maultxyz/mault/(list of files, cad)

Other CAD files:
3d model/Card Sorter.step
3d model/Card Sorter.f3d
3d model/card_sorter.3mf
