maultxyz/mault/packages/server/tests/fixtures/scan-control/invalid.png

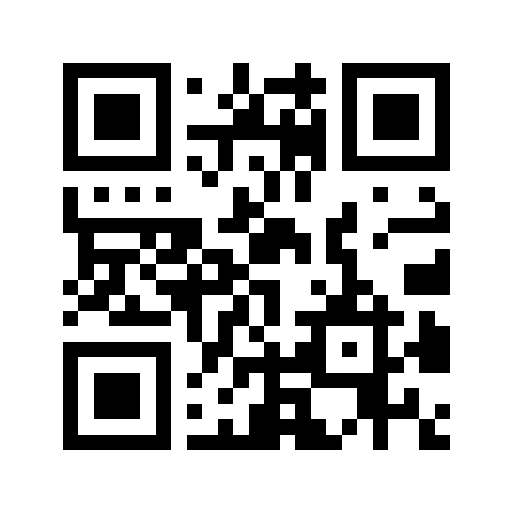
packages/server/tests/fixtures/scan-control/invalid.png
