maultxyz/mault/firmware/main/ble_esp32.ino

// BLE backend for ESP32-S3, using the Bluedroid stack bundled with the
// esp32:esp32 Arduino core (BLEDevice/BLEServer/BLECharacteristic - already
// installed by firmware-release.yml/firmware-pr-check.yml's `arduino-cli
// core install esp32:esp32`, no extra library needed). Implements the same
// bleInit()/blePoll()/bleIsConnected()/bleSendLine() contract as
// ble_arduinoble.ino so main.ino never branches on which backend is active -
// see main.ino's BLE_SUPPORTED/BLE_BACKEND_* macros for the board gating.
#if BLE_BACKEND_ESP32
#include <BLE2902.h>
#include <BLEDevice.h>
#include <BLEServer.h>
#include <BLEUtils.h>

// Nordic UART Service (NUS) - a widely-recognized BLE "serial" convention,
// reused here (rather than inventing our own UUIDs) so generic BLE terminal
// apps (nRF Connect etc.) can talk to this device for debugging without any
// app-specific tooling. RX = commands in (write), TX = responses/unsolicited
// messages out (notify) - see PROTOCOL.md's BLE Transport section. Must
// match ble_arduinoble.ino's UUIDs exactly, since the web client looks for
// one fixed service regardless of which board it's talking to.
#define BLE_SERVICE_UUID "6E400001-B5A3-F393-E0A9-E50E24DCCA9E"
#define BLE_RX_UUID "6E400002-B5A3-F393-E0A9-E50E24DCCA9E"
#define BLE_TX_UUID "6E400003-B5A3-F393-E0A9-E50E24DCCA9E"

#define BLE_PREFERRED_MTU 517
#define BLE_DEFAULT_MTU 23
#define BLE_ATT_HEADER_SIZE 3
#define BLE_CHUNK_GAP_MS 5
#define BLE_CONN_INTERVAL_MIN 6
#define BLE_CONN_INTERVAL_MAX 24
#define BLE_CONN_SUPERVISION_TIMEOUT 400
#define BLE_RX_RING_SIZE 512

char bleRxRing[BLE_RX_RING_SIZE];
volatile size_t bleRxHead = 0;
volatile size_t bleRxTail = 0;
portMUX_TYPE bleRxMux = portMUX_INITIALIZER_UNLOCKED;

bool bleRxPop(char& c) {
  bool available = false;
  portENTER_CRITICAL(&bleRxMux);
  if (bleRxTail != bleRxHead) {
    c = bleRxRing[bleRxTail];
    bleRxTail = (bleRxTail + 1) % BLE_RX_RING_SIZE;
    available = true;
  }
  portEXIT_CRITICAL(&bleRxMux);
  return available;
}

BLEServer* bleServer = nullptr;
BLECharacteristic* bleTxChar = nullptr;
volatile bool bleConnected = false;

class SorterServerCallbacks : public BLEServerCallbacks {
  void onConnect(BLEServer* server) override { bleConnected = true; }
#if defined(CONFIG_NIMBLE_ENABLED)
  void onConnect(BLEServer* server, ble_gap_conn_desc* desc) override {
    server->requestConnParams(desc->conn_handle, BLE_CONN_INTERVAL_MIN, BLE_CONN_INTERVAL_MAX, 0,
                              BLE_CONN_SUPERVISION_TIMEOUT);
  }
#elif defined(CONFIG_BLUEDROID_ENABLED)
  void onConnect(BLEServer* server, esp_ble_gatts_cb_param_t* param) override {
    server->requestConnParams(param->connect.remote_bda, BLE_CONN_INTERVAL_MIN,
                              BLE_CONN_INTERVAL_MAX, 0, BLE_CONN_SUPERVISION_TIMEOUT);
  }
#endif
  void onDisconnect(BLEServer* server) override {
    bleConnected = false;
    // Bluedroid stops advertising once connected and doesn't resume on its
    // own - restart it so a disconnected (or different) central can
    // reconnect without a power cycle.
    server->getAdvertising()->start();
  }
};

class SorterRxCallbacks : public BLECharacteristicCallbacks {
  void onWrite(BLECharacteristic* characteristic) override {
    String value = characteristic->getValue();
    portENTER_CRITICAL(&bleRxMux);
    for (size_t i = 0; i < value.length(); i++) {
      size_t next = (bleRxHead + 1) % BLE_RX_RING_SIZE;
      if (next == bleRxTail) break;
      bleRxRing[bleRxHead] = value[i];
      bleRxHead = next;
    }
    portEXIT_CRITICAL(&bleRxMux);
  }
};

void bleInit() {
  // deviceId is already populated by main.ino's setup() (via
  // initDeviceIdFromEspMac(), called before bleInit()) - reused here rather
  // than re-reading the MAC, since the Arduino BLE library's device-name API
  // varies across esp32-arduino core versions and it's simplest to just fold
  // the already-known ID into the name up front instead of depending on
  // being able to rename the device post-init.
  char localName[32];
  snprintf(localName, sizeof(localName), "Mault Sorter %s", deviceId);

  BLEDevice::init(localName);
  BLEDevice::setMTU(BLE_PREFERRED_MTU);
  bleServer = BLEDevice::createServer();
  bleServer->setCallbacks(new SorterServerCallbacks());

  BLEService* service = bleServer->createService(BLE_SERVICE_UUID);

  BLECharacteristic* rxChar = service->createCharacteristic(
      BLE_RX_UUID,
      BLECharacteristic::PROPERTY_WRITE | BLECharacteristic::PROPERTY_WRITE_NR);
  rxChar->setCallbacks(new SorterRxCallbacks());

  bleTxChar =
      service->createCharacteristic(BLE_TX_UUID, BLECharacteristic::PROPERTY_NOTIFY);
  // Required for notify() to actually reach a central - without a CCCD
  // descriptor present, some clients (and the underlying stack) won't treat
  // the characteristic as notifiable even though PROPERTY_NOTIFY is set.
  bleTxChar->addDescriptor(new BLE2902());

  service->start();
  bleServer->getAdvertising()->addServiceUUID(BLE_SERVICE_UUID);
  bleServer->getAdvertising()->start();
}

void blePoll() {
  char c;
  while (bleRxPop(c)) {
    feedByte(bleInput, c, bleReply);
  }
}

bool bleIsConnected() { return bleConnected; }

const char* bleState() { return bleConnected ? "connected" : "advertising"; }

uint16_t bleMtu() {
  if (!bleConnected || bleServer == nullptr) return 0;
  return bleServer->getPeerMTU(bleServer->getConnId());
}

void bleSendLine(const char* s) {
  if (!bleConnected || bleTxChar == nullptr) return;
  static char line[MAX_REPLY_LEN + 2];
  size_t len = strnlen(s, MAX_REPLY_LEN);
  memcpy(line, s, len);
  line[len++] = '\n';
  uint16_t mtu = bleMtu();
  size_t chunkSize = (mtu > BLE_DEFAULT_MTU ? mtu : BLE_DEFAULT_MTU) - BLE_ATT_HEADER_SIZE;
  for (size_t offset = 0; offset < len; offset += chunkSize) {
    if (offset > 0) delay(BLE_CHUNK_GAP_MS);
    size_t chunkLen = len - offset < chunkSize ? len - offset : chunkSize;
    bleTxChar->setValue((uint8_t*)(line + offset), chunkLen);
    bleTxChar->notify();
  }
}
#endif  // BLE_BACKEND_ESP32
