maultxyz/mault/(commit log)

2026-09-03 add buy links for new materials
2026-09-03 refactor: update NotifyBody interface and enhance thread handling in notifications
2026-09-04 add pricing to the landing page
2026-09-04 some styling updates on landing screen
2026-09-04 various accessibility fixes for the landing pages
2026-09-06 fix font sizing and buttons
2026-09-07 add rollbar test buttons
2026-09-07 add tutorial for calibration
2026-09-08 add de-jamming
2026-09-08 add copy calibration for debugging
2026-09-08 update exporting layout, and apply filters when exporting
2026-09-08 add feed button and stuff to top of calibration pages
2026-09-10 add foil type filter
2026-09-10 make it so buttons don't dissapear anymore
2026-09-11 update instructions to be more clear on what to print
2026-09-12 add sliders to make calibrating a little more intuitive
2026-09-12 add m2x8 screws to bom
2026-09-12 add importing and exporting calibrations
2026-09-12 remove extra debug button
2026-09-13 update default calibration values
2026-09-13 update calibrations
2026-09-13 fix compile issue with arduino
2026-09-13 fixes for ir sensor force scan
2026-09-14 Move devices to their own table to support multiple devices later
2026-09-17 add bluetooth option to any connect device button
2026-09-18 fix orgs not creating a device when being made
2026-09-18 backfill devices for orgs missing them
2026-09-18 device config stale check
2026-09-18 add landing page announcements
2026-09-18 update bom layout a little
2026-09-19 up button size
2026-09-19 fix servo connection issue
2026-09-20 add servo testing page for admins
2026-09-22 add resync all command, add device unique key
2026-09-23 add device communication to the footer
2026-09-23 add test button to calibration screen
2026-09-24 add initial attempt at multi device support
2026-09-24 remove section about 3d printed from bom
2026-09-24 fix servos being jittery sometimes
2026-09-24 add easier way to connect camera
2026-09-25 add new board flash to admin page
2026-09-26 tighten scoring and fix multiple scan logic
2026-09-26 remove game switch alert
2026-09-26 add drop button to toast
2026-09-26 add calibration tutorial
2026-09-27 add close buttons to toasts
2026-09-27 add camera selector to the calibration page
2026-09-28 fix support toast buttons
2026-09-28 only allow updating calibrations if no session is running
2026-09-28 add rest calibrations
2026-09-30 switch to storing cards in object storage
2026-10-01 updating wiring diagram
2026-10-01 add discord filtering
2026-10-01 add servo buy link
2026-10-01 group like buttons together
2026-10-02 rollback calibrations
2026-10-02 add device playground and upate kit testing
2026-10-02 fix camera not resizing to fit
2026-10-03 add device management page
2026-10-04 clear query button
2026-10-07 update the landing page
2026-10-07 update correcting card flow
2026-10-07 only calibrated devices
2026-10-08 add camera selector to mobile
2026-10-09 add button if all cards are hidden
2026-10-09 calibrate without sorter
2026-10-09 fix saving to device memeory
2026-10-09 offline calibrate wizard
2026-10-11 leader board
2026-10-12 update to recommend mg90s servo for feeder
2026-10-12 move leaderboard to button/modal
2026-10-13 update landing page
2026-10-14 fix 3d model calibration and instructions
2026-10-14 add firmware check on driver board
2026-10-14 Adding Collection Number for MTG
    Adding the collection number for a sorting rule in the MTG as a numeric value. The rule is added and filtered out by the game. So only the MTG should get this rule. The value will be present for all games, but should only matter for MTG. This is done with a regex check while the card is being scanned. Overhead should be pretty minimal as it's a small string and a simple regex rule validation.
2026-10-15 fix issues running multiple devices at the same time
2026-10-16 add esp connect to servo and control remotely
2026-10-19 fix mobile camera selector
2026-10-19 Add Raspberry Pi hosting and scanning.
    A Pi can run the app, the scan loop, and the USB webcam, and a remote browser can use that sorter. Catalog vectorizing can also run in the browser when the server reports it is a Pi.
2026-10-19 add new filter option for list count
2026-10-19 add pin instruction
2026-10-20 Install Raspberry Pi system packages from the setup script.
2026-10-20 Add a camera calibration aid on the scan setup page. A user picks a set and a card from the synced catalog and scores one camera frame.
2026-10-21 Since the Pi owns the device, you can now connect to the sorter to calibrate on mobile through the Pi's sorter connection as well as start a scan using the Pi connected webcam.
2026-10-21 update camera calibration to match coding standards
2026-10-21 flip camera
2026-10-21 fix flashing clearing board
2026-10-21 add ir sensor instruction
2026-10-21 add servo warning label
2026-10-21 Add the install user to dialout so the API can open the sorter on other linux distros. Raspberry Pi automatically does this.
2026-10-23 Detect USB cameras by connection instead of device name
2026-10-23 Fix buffered Pi camera captures and wait for settled frames
2026-10-23 fix landing page spider web
2026-10-25 ci: run server tests in build-check
    Adds a test step to build-check.yml so the existing server suite (evaluate-bin, ocr-calibration, card-condition; 60 tests) runs on every PR. Removes tests/ocr-anchor.test.ts, which was stale (3 of 4 failing) per the maintainer.
2026-10-25 add wifi to arduino
2026-10-25 test(web): add Vitest harness with useShiftClick regression tests
    Adds a test setup for packages/web and runs it in build-check.
    - vitest.config.ts (separate from vite.config.ts so tests skip the
    PWA/Tailwind plugins), jsdom environment, @/ alias
    - src/test/setup.ts: jest-dom matchers + cleanup between tests
    - "test" script and a Test (web) step in build-check.yml
    First tests pin the ranged-selection fix (51b0de72): a shift-click on a
    Base UI Checkbox must report shiftKey true, a plain click false, and
    shift must not leak into the next click. Verified these fail against
    the previous details.event pattern and pass against useShiftClick.
    Lockfile note: better-auth declares vitest as an op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
2026-10-25 test(web): pin jsdom to 26 for Node 20 CI
    jsdom 30 requires Node 22+ (via undici 8) and crashed on load under
    build-check's Node 20. jsdom 26 supports Node >=18. Verified the web
    tests pass on Node 20 and 22, and still fail against the old
    details.event pattern.
2026-10-25 fix device creation for new Neon orgs
    ensureDeviceForOrg posted to `${API_BASE}/devices`, which skips the /api
    prefix that the Vite proxy and nginx forward, so new orgs never got
    their device and an empty catch hid the failure. It now posts to
    /api/devices and logs a failed or rejected request instead of
    swallowing it.
2026-10-25 remove unused web code
    Each item was checked for references across every package first.
    - Unused files: CardSelectDialog (492 lines, with its props),
    CardDetailSkeleton, SectionHeading and DemoCardStrip.
    - Unused API wrappers: deleteBinRoute, getBinRouteHistory,
    revertBinRoute, deleteBinHeight, getBinHeightHistory,
    revertBinHeight, createDevice, clearUnmatchedCards,
    deleteAccuracyCheck, getSyncStatus.
    - Unused exports: isoDate, REPORT_*_PARAM, DEFAULT_DEVICE,
    MOBILE_CHIP_CLASS, SOCIAL_IMAGE_URL, RepackSlotFormValues,
    DemoStoredCard.
    - Props no caller passes: SaveBar saveDisabled,
    StorageLocationSelect includeNone, WifiSorterMenuItems
    showSeparator.
    - DynamicDialog's DialogCl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
2026-10-25 log server failures that were silently swallowed
    - withErrorHandling turned every card search adapter exception into
    "Could not reach the card database" and logged nothing. It now logs
    each failure, and reports anything other than a timeout or failed
    fetch (i.e. an adapter bug) to Rollbar.
    - forgot-password ignored requestPasswordReset failures. The response
    stays deliberately generic, but the failure is now logged and sent
    to Rollbar so a broken reset email shows up.
    - requireSorterClient turned a device lookup error into 404 "no
    device". It now lets the error reach the global handler (500 plus
    Rollbar).
2026-10-25 warn when turning off Wi-Fi leaves the server link behind
    forget() ignored a failed deleteSorterLink and reported success. The
    board has already forgotten the network by then, so the result now
    carries serverLinkRemovalFailed and the desktop and mobile web panels
    show a warning (sorterWifi.forgottenLinkKept, in en/de/fr) explaining
    the old link is replaced the next time Wi-Fi is set up.
2026-10-25 fail mobile sorter connect cleanly when bring-up throws
    After the transport opened, connect had no error handling around
    identify, device binding, the lease, calibration sync, the self-test or
    sendNeutral, and callers fire it with void. A thrown API call left the
    phase stuck at "syncing" with the lease held and no error shown. The
    bring-up is now wrapped so a throw tears down (releasing the lease) and
    shows the existing connect-failed error, as recoverFromReset already
    did.
2026-10-25 translate the missing German and French web strings
    The de and fr web locales were missing 87 keys that en has: API keys
    (account), local sign-in, sign-up, invite join and password reset
    (auth), invites and the activity log (companies, settings) and the
    Rollbar test page (admin). They're added in the existing informal
    tone (du / tu), so every web locale file now has identical keys.
    Also removes build.json's printSortingModule.note from de and fr (en no
    longer has it), and switches six French strings added recently from
    vous to tu: setupWizard.completeFailed and the Wi-Fi needsWifiBoard,
    sharesRadio and forgottenLinkKept copy.
2026-10-25 replace em dashes in user-facing copy with colons
    CLAUDE.md bans em dashes in copy. Updated the Discord alert titles
    ("Mault: Sync Failed", "Mault: Card Search Error" and the test
    variants), the scan session embed, the bot's collection stats title,
    the sync error message that joins an error with its cause, and the
    admin card sync status badge.
    Card typeLine values in the adapters and demo cards keep their em
    dash: they mirror the printed type line (Scryfall's data uses it) and
    rules match against that text.
2026-10-25 drop duplicate serial console traces
    use-serial logged every line sent to and received from the sorter
    with console.log behind eslint-disable comments. pushCommLog already
    records each line for the device comm log, so the console copies only
    added noise and the two lint suppressions CLAUDE.md forbids.
2026-10-25 Share firmware reply parsing between web and mobile
    Add parseSerialReply to shared serial-protocol: it returns the reply as
    an object, or null for a missing line, invalid JSON or a non-object.
    The jam toast, serial provider, calibration sync, IR reads, the web
    SorterLink Wi-Fi status and the mobile SorterLink now use it instead of
    their own JSON.parse copies. IR reads on the scanner no longer throw on
    a malformed reply.
2026-10-25 Write device updates to the devices cache through one helper
    Add writeDeviceToCache to the devices API: it replaces the matching
    device in the cached list, appends a new one, and leaves an uncached
    list alone. The device toggles draft, setup wizard, channel layout
    upgrade, module count config and serial provider used their own
    setQueryData copies, some of which created a one-item list when nothing
    was cached yet.
2026-10-25 Build the localStorage flag hooks from createStoredFlag
    The sorter model beta, hand scan and ignore IR sensors flags each had
    their own copy of a useSyncExternalStore hook over one localStorage
    key. lib/stored-flag.ts now creates that hook once per key; the IR
    sensor flag keeps its admin-only check on top.
2026-10-25 Share the connect sorter menu and the Web Bluetooth check
    ConnectSorterMenuItems renders the USB, Bluetooth (when supported) and
    Wi-Fi sorter entries that the scanner menu, scanner overlay, station
    tabs and calibrate page each built by hand. The calibrate page now uses
    the scanner strings, so its identical connectUsb/connectBluetooth
    strings are removed from every locale, and it no longer passes the
    click event to connect() as options. isWebBluetoothSupported replaces
    six copies of the navigator.bluetooth check.
2026-10-25 Share the save request flow of the admin settings drafts
    The plan settings, Discord channels, Discord linked role and platform
    stats drafts each wrapped their save in the same try/catch: error toast
    with the server message or a fallback, apply the result, success toast.
    requestWithToasts now runs that flow, and the drafts only say what to
    do with the saved data. Post now on platform stats uses it as well.
2026-10-25 Share StatCell between the session summary and stats panel
    The session summary dialog and the scanner's session stats panel each
    defined the same label/value StatCell with an inline prop type. It now
    lives in components/stat-cell with StatCellProps in the stat-group
    interfaces; the summary dialog keeps its tighter padding through
    className.
2026-10-25 Stop camera streams through one stopMediaStream helper
    The camera, phone camera and QR scanner hooks each stopped a stream's
    tracks with their own loop. camera-stream now exports stopMediaStream,
    and use-camera releases its local stream (stop, clear the ref and the
    state) through one releaseLocalStream callback instead of three copies.
2026-10-25 Share the firmware response timeouts between web and mobile
    Both apps defined the same serial, self-test, route, push test, jam,
    store config, device lease and sorter link timings. They now live once
    in shared serial-timing constants. The mobile store config timeout was
    5 s against 10 s on web; both now wait 10 s.
2026-10-25 Share the servo pulse math between web and mobile
    Both apps converted servo pulses to percentages and directional feeder
    speeds with their own copies; mobile's lacked the custom stop-center
    parameter. The pulse range constants, DirectionalSpeed and the
    conversions (including recenterSpeedPulse and directionalSpeedToPulse)
    now live in shared servo-pulse, and the functions are out of the web
    constants file.
2026-10-25 Translate the remaining web-only form validation messages
    The business, device, device playground, email verification and bin
    preset schemas hardcoded English error text. They now use validation
    keys, so the messages follow the selected language. The device raw
    console shows its command error through FieldError so the key gets
    translated.
2026-10-25 Share the scan identify decisions between web and mobile
    Both scanners carried the same pure steps around the embedding search:
    deciding whether a result matched, whether to fall back to OCR,
    picking the better orientation, looking up the close matches,
    preferring the detected color and assembling the matched or unmatched
    diagnostics. Shared scan-identify now owns those, typed by a shared
    ScanAttemptResult that each app's attempt extends; the apps keep only
    capture, inference and image handling. A card lookup that throws on
    web now ends the attempt as lookup_failed like on mobile instead of
    failing the scan, and the mobile type error in the close-match filter
    is gone with the old copy.
2026-10-25 Move the serial session core into shared and run mobile on it
    Web use-serial and mobile SorterLink each implemented the same serial
    session: line buffering, seq-tagged reply matching with the untagged
    fallback, the write queue, the exclusive-command guard, the route
    queue that skips routes after a failed one, and the comm log. Shared
    SerialSession now holds that, with the text decoder and encoder
    injected (Hermes has no streaming TextDecoder) and boot banners handed
    to an onBootBanner hook. Mobile SorterLink is now a SerialSession that
    only adds feed(), and the mobile copies of its reply, log and route
    types are replaced by the shared ones. Chunks from a transport that
    was already detached a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
2026-10-25 Clear the remaining mobile type errors
    - Settings section links accept the sounds, notifications and webhooks
    paths the list already used.
    - The keep-awake cleanup no longer returns a promise from the effect.
    - Tab icons fall back to the theme color when the tab bar hands over a
    non-string color value.
    - useAppState narrows AppState.currentState (null before the first
    event) and defaults to active.
    - The model checksum takes an ArrayBuffer-backed byte array, which is
    what expo-crypto accepts.
    - App alerts build a typed list before dropping the empty entries.
    - app.config drops newArchEnabled, which Expo SDK 58 no longer has.
    The mobile app now type-checks with no errors.
2026-10-25 Clear the remaining server type errors
    - The public API router registers each endpoint with its middleware
    listed explicitly, so Hono's on() overloads resolve.
    - Emptying a bin only emits the cards-stored webhook when stored scan
    ids are present.
    - detachClient checks the sorter link exists before comparing its
    client socket.
    - invites-add and session-init import InviteCapture and ViewerInfo
    from the interfaces modules that declare them.
    - tsconfig adds the ES2022 lib (keeping DOM) for Error.cause, which
    the sync worker already reads.
    The server now type-checks with no errors.
2026-10-25 Move route and hook constants into lib/constants and lib/interfaces
    The business routes declared their not-found messages, the
    forbidden/upgrade-required results, BusinessResult and the stored
    accuracy sample type locally; they now live in the server's
    lib/constants/business and lib/interfaces/business with descriptive
    names (SPOT_CHECK_NOT_FOUND_MESSAGE, BUSINESS_FORBIDDEN_RESULT, ...).
    The mobile session stream's initial state moves to
    lib/constants/monitor as INITIAL_MONITOR_STATE.
2026-10-25 Share the Wi-Fi sorter link connection between web and mobile
    The web and mobile CloudTransport each opened the sorter-link socket,
    waited for the ready message, mapped close codes to offline/in use,
    buffered messages until start() and converted text frames to bytes.
    Shared now has openSorterLinkSocket and a SorterLinkConnection base
    class with the text codec injected; each CloudTransport only adds its
    app's transport fields, and mobile maps the shared failure to its
    error codes. Web's CloudTransportFailure is replaced by the shared
    SorterLinkOpenFailure.
2026-10-25 Raise sorter alerts from the mobile app
    The mobile scanner paused on jams, failed routes, an empty feeder and
    missing cards but never told the server, so sorters run from the app
    raised no device alert, Discord post or sorter.alert webhook. It now
    reports them through /notifications/serial-event like web: "bin" for
    route failures (with the card name and bin), "auto-feed" or "feeder"
    for feed problems, and "jam" for jam messages.
2026-10-25 Release the collection scan lock from the mobile app
    Saving a scan takes the collection's scan lock, and web releases it
    when you switch collections or leave the scanner. The mobile app never
    released it, so other users saw the collection as locked until the
    lock timed out. The scan session now releases the lock for the old
    collection when the active collection changes and when the session
    unmounts. Also drops a trailing comment from the release route.
2026-10-25 Let the mobile scanner force a foil type and a set
    Web can mark the cards being scanned as a given foil type and steer
    matching to one set; the mobile app couldn't, so foil rules never
    matched and every mobile save was non-foil. Scan options now has Foil
    type (Not foil plus the game's foil types) and Set (Any set plus the
    collection's sets, searchable). The forced foil feeds routing rules
    and the saved record, the forced set is sent as preferredSetCode, and
    both reset when the active collection changes. OptionSheet gains an
    optional search field and visible-option cap for long lists.
2026-10-25 Add the repack "multiple packs per bin" setting to the mobile app
    Web's repack editor lets a bin start a new pack on top of a finished
    one; the mobile editor had no such switch, so mobile users couldn't
    turn it on and saving the editor never sent it. It now has the same
    switch and strings as web, saved through the repack config. Turning
    repack mode on or off from the mode screen still leaves the setting
    as it was.
2026-10-25 fix disabled calibrations during scan
2026-10-25 move filter items to drawer
2026-10-25 move the add remove switches
2026-10-27 fix mobile view of landing page
2026-10-28 update bom
2026-10-29 add share calibration and share rule logic
2026-10-31 cut servo signal if voltage drops
2026-10-31 fix device badge
2026-11-01 update FaB pitch detection
2026-11-02 fix print issue
2026-11-02 add powertools csv export
2026-11-03 fix camera on firefox
2026-11-03 add multi-preset stages
2026-11-03 add sample sorting
2026-11-04 Add native Raspberry Pi sorter control
2026-11-04 add brand to print sheet
2026-11-05 wasm multi-thread
2026-11-05 add notification button/icon
2026-11-07 Fix Pi camera manual focus control and restoration
2026-11-07 Preserve Pi camera focus and running scan foil settings
2026-11-09 change fab pitch detection
2026-11-09 Add Orange Pi native control and improve headless Pi camera setup
2026-11-09 update bom with new washer size
2026-11-09 add bearings to bom
2026-11-10 Share card identification across scan clients
    Browser, native mobile and Pi now share orientation selection, conditional OCR ranking and consensus. Keep camera, image conversion and inference access in their existing adapters.
2026-11-10 update landing pages
2026-11-10 fix(calibration): align Pi errors with ordinary installation behavior
    Remove Pi-only query and save throws from sorter calibration settings. Reuse the ordinary installation error behavior for device configuration, bin heights, bin routes and module counts.
2026-11-11 fix(pi-camera): restore saved manual focus after startup
    Any browser can adjust focus on the camera. This forces manual focus writes through an adjacent in-range position, then
    reapply the saved value after a two-second startup settling interval
    before accepting browser requests.
2026-11-11 switch how cards are stored in cache
2026-11-11 fix(sync): reduce peak memory during catalog merging
    ARM binaries have a 2gig memory limit, and vectorization can blow through that. This retains compact card summaries and normalize raw-dependent parallel matching only when needed. Consume the source array in place and append grouping entries without repeated array copies.
2026-11-11 test(pi): cover controller, scanning, camera and sync behavior
    Add server, browser and Python regressions for GPIO identity and feature
    reporting, shared controller connections, authenticated transports,
    exclusive motion, pipeline prefetch, calibration and running settings.
    312 server tests, 61 web tests, 38 Pi utility tests and 14 controller tests passed.
2026-11-11 fix(games): allow retry after failed sample-card searches
    Show the existing error message and clear Loading when a sample-card search fails, so users can retry without reloading. Announce errors to screen readers and cover failed requests and successful retries with regression tests.
2026-11-12 feat(scanner): share scan workflow across web, mobile and Pi
    Share scan decisions, routing plans and save/completion stages.
    Integrate control cards, removal, foil detection and sound selection
    with headless Pi scanning.
2026-11-12 fix(storage): use the host camera for Pi verification scans
2026-11-12 fix camera crash
2026-11-12 fix switches
2026-11-12 fix button legibility
2026-11-13 Fix Pi scan save recovery, calibration timeouts and review findings
    - Pi pending saves: accepted rejections (402/409/423) settle the save like
    web and mobile, other permanent rejections are set aside as .rejected so
    they no longer block every later scan; 403 is still kept. Recovery at
    start is capped at PI_SCAN_RECOVERY_MAX_ATTEMPTS instead of retrying until
    stopped.
    - A missing pick-list bin no longer fails the card save; the scan is saved
    without pick progress.
    - Sorter calibration commands use the neutral timeout, since
    setChannelOffset drives every module to neutral.
    - Pi foil nudge rotates the after-capture to match a rotated match image.
    - runScanDisposition commits the pla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
